kdotchandra/ball-balancing-robot/README.md

# Ball-Balancing Robot (3-DOF Parallel Platform)

Capstone Design Project, Mechatronics Engineering, Suranaree University of Technology (2026).
Team of 3. I was responsible for the wiring, assembly, and all software.

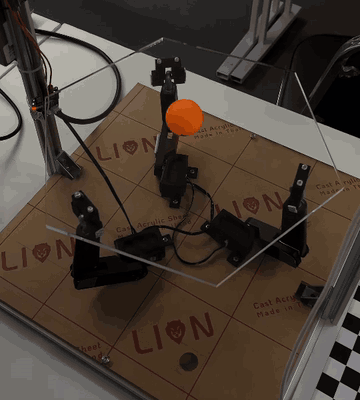
[picture p1: docs/media/demo_balance.gif]
The platform keeps a ping-pong ball on the plate while the ball is pushed away with a stick


*Balance: the ball is pushed away with a stick and the plate brings it back.*

## What it does
A 3RRS platform tilts a plate to keep a ping-pong ball balanced at the center
and to move it along a circle or hexagon path.

| Demo | Result (tuned profiles, 2026-09-28) |
|---|---|
| Balance | Ball placed 5–9 cm from center is brought within 2 cm in about 0.5–5 s |
| Circle, 3 cm radius | Tracking error about 1.3–1.5 cm |
| Hexagon, 3.46 cm to corner | Tracking error about 1.4–2.1 cm |

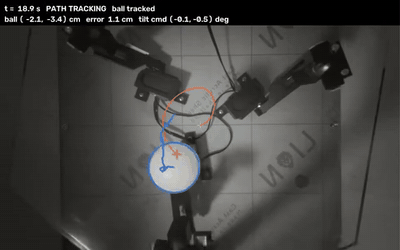
[picture p2: docs/media/demo_circle.gif]
Overhead camera view: the ball follows a circular reference path
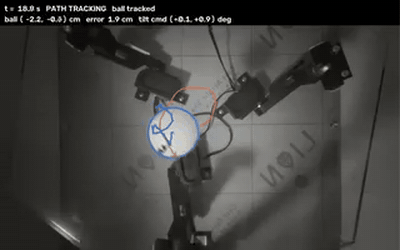
[picture p3: docs/media/demo_hexagon.gif]
Overhead camera view: the ball follows a hexagonal reference path
 

*Circle (left) and hexagon (right) paths, seen by the control camera: orange is the reference path, blue is the detected ball and its recent path.*

## How it works
```
Camera (OV9281, 30 fps) -> ball detection (OpenCV) -> alpha-beta velocity filter
-> LQR controller -> plate tilt angles -> linearized inverse kinematics
-> servo commands over UART -> 3 x HX-35H servos
```
Plate tilt is converted to servo angles with the inverse kinematics of the 3RRS mechanism, linearized
around the neutral pose (a fixed 3x2 matrix in `servo_calibration/config/servo_mapping.json`; the servo
directions were checked on the real platform). The exact inverse kinematics (`kinematics.py`) is kept for
checking and simulation: with the CAD geometry it differs from the linear map by about 2.5% at small
tilts, and by less than 2 servo counts within ±3° of tilt.

## Hardware
- Raspberry Pi 5 (Raspberry Pi OS, Python)
- OV9281 global-shutter camera, mounted about 25 cm above the plate
- 3 x Hiwonder HX-35H bus servos, driven from the Pi's UART through a Hiwonder BusLinker v3.0
- 12 V 16.7 A power supply for the servos; the Pi has a separate supply
- 3RRS mechanism with an acrylic plate and a 40 mm ping-pong ball

## Repository layout
```
docs/                     Handoff notes, demo instructions (Thai)
test_integrated_system/   Main control loop (main.py), controller, tracker, calibration, tests
ping_pong_tracker/        Camera and detector setup, calibration files
servo_*/                  Arduino sketches used for early servo tests
```

## Run the demo
See [docs/DEMO_RUN.md](docs/DEMO_RUN.md). Full project notes: [docs/HANDOFF.md](docs/HANDOFF.md).

Tests run without hardware:
```bash
python -m pytest test_integrated_system/tests
```

## Known limitations
- Stick-slip friction between the ball and the plate limits accuracy.
- The camera only sees about +/-8 cm from the center.
- Total loop delay is about 170 ms (camera, detection, command timing and servo response).

## License
MIT. See [LICENSE](LICENSE).
