kdotchandra/ball-balancing-robot/docs/DEMO_RUN.md

# วิธีรัน Demo (Ball-and-Plate)

## เตรียมก่อนรัน

1. เช็กพินและข้อต่อทุกตัวว่าแน่น (พินหลวมทำให้ balance แย่ลงมาก)
2. เตรียมมือไว้ใกล้สวิตช์ไฟ servo
3. ปิด `web_stream.py` ก่อน เพราะกล้องใช้ได้ทีละโปรแกรม
4. เข้าโฟลเดอร์

```bash
cd /home/rpi5/capstone_design/test_integrated_system
```

## ตอนแสดงจริง (ทำงานต่อเนื่องจนกว่าจะกด Ctrl+C)

| Demo | คำสั่ง | วางบอลที่ |
|---|---|---|
| Balance | `./demo_balance.sh` | ตรงไหนก็ได้ในระยะกล้อง (ห่างกลางไม่เกิน ~7 cm) |
| เดินตามเส้นวงกลม | `./demo_circle.sh` | ใกล้กลาง |
| เดินตามเส้นหกเหลี่ยม | `./demo_hexagon.sh` | ใกล้กลาง |

ขั้นตอน:

1. พิมพ์คำสั่ง
2. วางบอลบนแผ่น
3. กด **Enter** เมื่อขึ้นข้อความให้ยืนยัน
4. กด **Ctrl+C** เมื่อต้องการหยุด แผ่นจะกลับไปที่ neutral และสคริปต์แสดงบรรทัด `RESULT:` สรุปผล

ลำดับการทำงานของวงกลมและหกเหลี่ยม: ทรงตัวที่กลาง 6 s → ค่อยๆ ขยายเส้นออก 5 s → วิ่งตามเส้นวนไปเรื่อยๆ (รอบละ 20 s)

## ให้หยุดเองตามเวลา (ตอนอัดวิดีโอไปทำกราฟ หรือเก็บข้อมูล)

```bash
./demo_balance.sh --duration-s=25
./demo_circle.sh --duration-s=50
./demo_hexagon.sh --duration-s=50
```

ทุก demo อัดวิดีโอเก็บไว้ใน `logs/video_<เวลา>.mp4` และ log ใน `logs/run_<เวลา>.csv` (tag แสดงตอนจบรอบ)

## ข้อควรจำ

- หยุดด้วย **Ctrl+C ครั้งเดียว** ห้ามใช้ Ctrl+Z (process จะค้างถือกล้องและ servo ไว้)
- รันทีละตัว รอให้ตัวก่อนจบก่อน
- ถ้าบอลหลุด แผ่นกลับ neutral แล้วรอ วางบอลกลับแล้วระบบควบคุมต่อเอง
  - วงกลม/หกเหลี่ยม เส้นยังเดินต่อจากเวลาเดิม ถ้าอยากเริ่มใหม่ตั้งแต่ช่วงทรงตัวที่กลาง ให้ Ctrl+C แล้วรันใหม่
- ระวังมือหรือเงาบังกล้องระหว่างรัน
- วิดีโอจะใหญ่ขึ้นตามเวลาที่รัน ถ้าแสดงนานหลายนาที เช็กพื้นที่ดิสก์ด้วย

## ถ้ามีปัญหา

| อาการ | ทำอย่างไร |
|---|---|
| ขึ้นว่ามีโปรแกรมกล้องอื่นทำงานอยู่ | ปิดโปรแกรมนั้นด้วย Ctrl+C หรือ `pkill -f web_stream.py` แล้วรันใหม่ |
| บอลแกว่งเป็นจังหวะเร็ว ~1 ครั้งต่อวินาที และแรงขึ้นเรื่อยๆ | กด Ctrl+C แล้วรันใหม่ ถ้าเกิดซ้ำให้เช็กพินและข้อต่อ |
| Pi ดับหรือรีบูตเองระหว่างรัน | เช็กแหล่งจ่ายไฟ (servo อาจดึงกระแสจนไฟตก) |
| จับบอลไม่ได้ / วงเขียวไปจับที่อื่น | เช็กแสงในห้อง ดูภาพผ่าน `web_stream.py` (ต้องปิดก่อนรัน demo) |

## ค่าที่ใช้ในแต่ละ demo (จูนเมื่อ 2026-09-28)

ค่าอยู่ที่เดียวใน `test_integrated_system/experiment_profile.py` → `PROFILES` (พร้อม comment หลักฐานของแต่ละค่า)
ดูได้ด้วย `python experiment_profile.py --list`

| Demo | Profile | ผลจากการทดสอบ |
|---|---|---|
| Balance | `tuned_balance` | ดึงบอลที่วางห่างกลาง 5–9 cm เข้ามาใกล้กลาง 2 cm ภายใน ~0.5–5 s; ผลักบอลออก 5 ครั้งดึงกลับได้ทุกครั้ง |
| วงกลม (รัศมี 3 cm) | `tuned_circle` | tracking error ~1.3–1.5 cm, 14 รอบไม่แกว่งค้าง |
| หกเหลี่ยม (รัศมีถึงมุม 3.46 cm) | `tuned_hexagon` | tracking error ~1.4–2.1 cm, ไม่แกว่งค้าง |

- ค่า standard (ที่รายงานบทที่ 4 ใช้) ยังเป็นค่าเริ่มต้นของ `run_real_balance.sh` ไม่ได้เปลี่ยน
- หกเหลี่ยมไม่ใช้ dz-lead เพราะทั้ง 0.25° และ 0.40° ทำให้แกว่งค้างจนบอลหลุดเป็นครั้งคราว
- dz-lead ของวงกลมเกิน ~0.4° จะเริ่มแกว่งค้าง (0.70° แกว่งที่ 0.74 Hz)
- รายละเอียดทั้งหมด: [HANDOFF.md](HANDOFF.md)
