kdotchandra/ball-balancing-robot/ping_pong_tracker/camera_capture.png

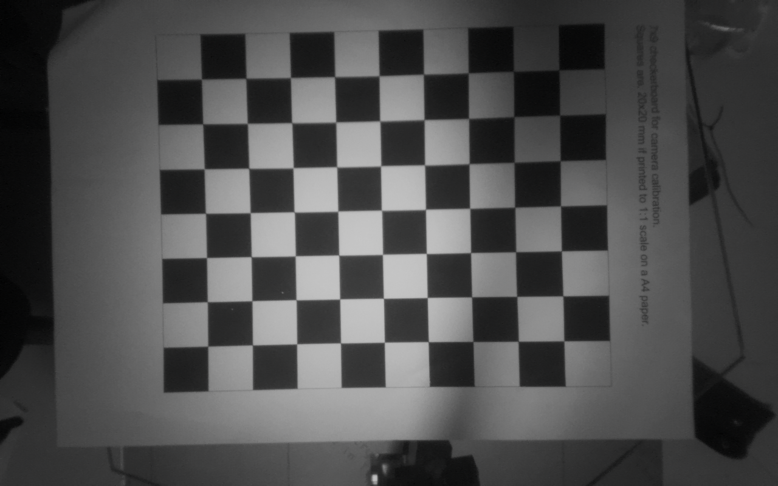
ping_pong_tracker/camera_capture.png
