kdotchandra/ball-balancing-robot/ping_pong_tracker/flat_field.png

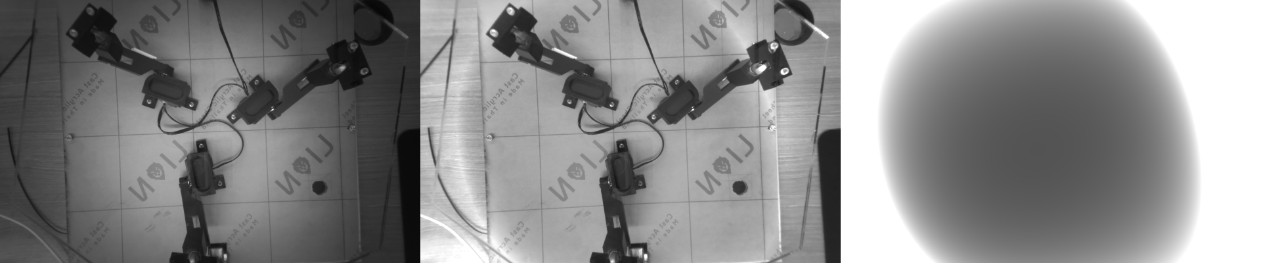
ping_pong_tracker/flat_field.png
