kdotchandra/ball-balancing-robot/test_integrated_system/logs/detect_20260927T065947Z.csv

t_s | dt_s | detected | confidence | x_m | y_m | x_px | y_px | radius_px | frame_age_s
0.0930 | 0.0160 | 0 |  |  |  |  |  |  | 0.0104
0.1124 | 0.0787 | 1 | 0.963 | 0.02161 | 0.03266 | 726.0 | 270.0 | 74.0 | 0.0225
0.1303 | 0.0212 | 1 | 0.963 | 0.02161 | 0.03266 | 726.0 | 270.0 | 74.0 | 0.0103
0.1637 | 0.0335 | 1 | 0.963 | 0.02211 | 0.03216 | 728.0 | 272.0 | 74.0 | 0.0106
0.1977 | 0.0334 | 1 | 0.988 | 0.02110 | 0.03316 | 724.0 | 268.0 | 78.0 | 0.0106
0.2305 | 0.0333 | 1 | 0.975 | 0.02161 | 0.03266 | 726.0 | 270.0 | 76.0 | 0.0106
0.2637 | 0.0334 | 1 | 0.975 | 0.02161 | 0.03266 | 726.0 | 270.0 | 76.0 | 0.0106
0.2985 | 0.0332 | 1 | 0.975 | 0.02211 | 0.03266 | 728.0 | 270.0 | 76.0 | 0.0105
0.3276 | 0.0334 | 1 | 0.963 | 0.02161 | 0.03266 | 726.0 | 270.0 | 74.0 | 0.0106
0.3637 | 0.0333 | 1 | 0.975 | 0.02161 | 0.03266 | 726.0 | 270.0 | 76.0 | 0.0106
0.3970 | 0.0334 | 1 | 0.975 | 0.02211 | 0.03266 | 728.0 | 270.0 | 76.0 | 0.0106
0.4306 | 0.0332 | 1 | 0.988 | 0.02110 | 0.03316 | 724.0 | 268.0 | 78.0 | 0.0105
0.4609 | 0.0335 | 1 | 0.988 | 0.02110 | 0.03316 | 724.0 | 268.0 | 78.0 | 0.0107
0.4943 | 0.0332 | 1 | 0.963 | 0.02161 | 0.03266 | 726.0 | 270.0 | 74.0 | 0.0105
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
