kdotchandra/ball-balancing-robot/test_integrated_system/logs/run_20260923T205222Z.csv

t_s | dt_s | mode | detected | control_valid | confidence | x_m | y_m | x_ref_m | y_ref_m | x_dot_mps | y_dot_mps | theta_x_cmd_deg | theta_y_cmd_deg | theta_x_actual_deg | theta_y_actual_deg | servo1 | servo2 | servo3 | missed_frames | lost_neutralized
0.1096 | 0.1521 | 1 | 0 | 0 |  | 0.00000 | 0.00000 | 0.00000 | 0.00000 | 0.00000 | 0.00000 | 0.000 | 0.000 | 0.000 | 0.000 | 441 | 402 | 423 | 0 | 0
0.1992 | 0.1099 | 1 | 1 | 1 | 0.869 | -0.00201 | -0.03241 | 0.00000 | 0.00000 | -0.01829 | -0.29487 | 1.912 | -10.163 | 1.158 | -6.156 | 459 | 437 | 458 | 0 | 0
0.3231 | 0.1132 | 1 | 1 | 1 | 0.848 | -0.00201 | -0.03191 | 0.00000 | 0.00000 | 0.00000 | 0.00444 | -0.956 | 0.316 | -0.161 | -2.116 | 459 | 437 | 458 | 0 | 0
0.4290 | 0.0999 | 1 | 1 | 1 | 0.879 | -0.00201 | -0.03191 | 0.00000 | 0.00000 | 0.00000 | 0.00000 | 0.850 | -6.335 | 0.396 | -4.440 | 449 | 450 | 471 | 0 | 0
0.5579 | 0.1279 | 1 | 1 | 1 | 0.812 | -0.00301 | -0.03090 | 0.00000 | 0.00000 | -0.00786 | 0.00786 | 1.134 | -1.645 | 0.916 | -2.470 | 452 | 415 | 436 | 0 | 0
0.6684 | 0.1280 | 1 | 1 | 1 | 0.767 | -0.00779 | -0.03090 | 0.00000 | 0.00000 | -0.03729 | 0.00000 | 1.912 | -5.492 | 1.618 | -4.602 | 452 | 415 | 436 | 0 | 0
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
