kdotchandra/ball-balancing-robot/test_integrated_system/logs/run_20260923T205301Z.csv

t_s | dt_s | mode | detected | control_valid | confidence | x_m | y_m | x_ref_m | y_ref_m | x_dot_mps | y_dot_mps | theta_x_cmd_deg | theta_y_cmd_deg | theta_x_actual_deg | theta_y_actual_deg | servo1 | servo2 | servo3 | missed_frames | lost_neutralized
0.0922 | 0.1521 | 1 | 0 | 0 |  | 0.00000 | 0.00000 | 0.00000 | 0.00000 | 0.00000 | 0.00000 | 0.000 | 0.000 | 0.000 | 0.000 | 441 | 402 | 423 | 0 | 0
0.1969 | 0.0925 | 1 | 1 | 1 | 0.730 | -0.02487 | -0.00578 | 0.00000 | 0.00000 | -0.26890 | -0.06247 | 1.912 | -8.368 | 0.974 | -4.266 | 459 | 437 | 458 | 0 | 0
0.3057 | 0.1251 | 1 | 1 | 1 | 0.738 | -0.02462 | -0.00553 | 0.00000 | 0.00000 | 0.00201 | 0.00201 | 1.912 | 1.102 | 1.621 | -0.563 | 459 | 437 | 458 | 0 | 0
0.4053 | 0.0880 | 1 | 1 | 1 | 0.738 | -0.02462 | -0.00553 | 0.00000 | 0.00000 | 0.00000 | 0.00000 | 1.912 | -0.797 | 1.762 | -0.676 | 459 | 402 | 423 | 0 | 0
0.5314 | 0.1202 | 1 | 1 | 1 | 0.706 | -0.02537 | -0.00678 | 0.00000 | 0.00000 | -0.00627 | -0.01045 | 1.912 | -2.110 | 1.861 | -1.626 | 459 | 410 | 431 | 0 | 0
0.6564 | 0.1279 | 1 | 1 | 1 | 0.637 | -0.02789 | -0.00703 | 0.00000 | 0.00000 | -0.01964 | -0.00196 | 1.912 | 0.168 | 1.897 | -0.361 | 459 | 392 | 413 | 0 | 0
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
