kdotchandra/ball-balancing-robot/test_integrated_system/logs/run_20260923T210003Z.csv

t_s | dt_s | mode | detected | control_valid | confidence | x_m | y_m | x_ref_m | y_ref_m | x_dot_mps | y_dot_mps | theta_x_cmd_deg | theta_y_cmd_deg | theta_x_actual_deg | theta_y_actual_deg | servo1 | servo2 | servo3 | missed_frames | lost_neutralized
0.0819 | 0.1521 | 1 | 0 | 0 |  | 0.00000 | 0.00000 | 0.00000 | 0.00000 | 0.00000 | 0.00000 | 0.000 | 0.000 | 0.000 | 0.000 | 441 | 402 | 423 | 0 | 0
0.1592 | 0.0823 | 1 | 1 | 1 | 0.821 | -0.01683 | 0.00980 | 0.00000 | 0.00000 | -0.20448 | 0.11903 | 1.912 | 1.102 | 0.867 | 0.500 | 459 | 392 | 413 | 0 | 0
0.2487 | 0.0996 | 1 | 1 | 1 | 0.817 | -0.01633 | 0.00980 | 0.00000 | 0.00000 | 0.00504 | 0.00000 | 1.912 | 1.102 | 1.441 | 0.831 | 459 | 392 | 413 | 0 | 0
0.3154 | 0.0665 | 1 | 1 | 1 | 0.814 | -0.01633 | 0.00955 | 0.00000 | 0.00000 | 0.00000 | -0.00378 | 1.912 | 1.102 | 1.613 | 0.930 | 459 | 392 | 413 | 0 | 0
0.4029 | 0.0894 | 1 | 1 | 1 | 0.815 | -0.01532 | 0.01055 | 0.00000 | 0.00000 | 0.01125 | 0.01125 | 0.936 | 1.102 | 1.280 | 1.015 | 459 | 392 | 413 | 0 | 0
0.4798 | 0.0647 | 1 | 1 | 1 | 0.807 | -0.01432 | 0.01080 | 0.00000 | 0.00000 | 0.01552 | 0.00388 | 0.691 | 1.102 | 1.069 | 1.046 | 448 | 392 | 413 | 0 | 0
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
