kdotchandra/ball-balancing-robot/test_integrated_system/logs/run_20260923T210017Z.csv

t_s | dt_s | mode | detected | control_valid | confidence | x_m | y_m | x_ref_m | y_ref_m | x_dot_mps | y_dot_mps | theta_x_cmd_deg | theta_y_cmd_deg | theta_x_actual_deg | theta_y_actual_deg | servo1 | servo2 | servo3 | missed_frames | lost_neutralized
0.1075 | 0.1522 | 1 | 0 | 0 |  | 0.00000 | 0.00000 | 0.00000 | 0.00000 | 0.00000 | 0.00000 | 0.000 | 0.000 | 0.000 | 0.000 | 441 | 402 | 423 | 0 | 0
0.1956 | 0.1076 | 1 | 1 | 1 | 0.814 | -0.02035 | -0.02638 | 0.00000 | 0.00000 | -0.18904 | -0.24505 | 1.912 | -10.163 | 1.134 | -6.030 | 459 | 437 | 458 | 0 | 0
0.3064 | 0.1108 | 1 | 1 | 1 | 0.774 | -0.02135 | -0.02588 | 0.00000 | 0.00000 | -0.00907 | 0.00454 | 1.912 | 1.102 | 1.609 | -1.675 | 459 | 437 | 458 | 0 | 0
0.3946 | 0.0878 | 1 | 1 | 1 | 0.811 | -0.02010 | -0.02562 | 0.00000 | 0.00000 | 0.01431 | 0.00286 | 1.912 | -4.822 | 1.755 | -3.197 | 459 | 432 | 453 | 0 | 0
0.5071 | 0.1081 | 1 | 1 | 1 | 0.820 | -0.02135 | -0.02512 | 0.00000 | 0.00000 | -0.01162 | 0.00465 | 1.912 | -2.153 | 1.848 | -2.575 | 459 | 432 | 453 | 0 | 0
0.6057 | 0.0925 | 1 | 1 | 1 | 0.769 | -0.02286 | -0.02437 | 0.00000 | 0.00000 | -0.01630 | 0.00815 | 1.912 | -2.507 | 1.881 | -2.540 | 459 | 413 | 434 | 0 | 0
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
