kdotchandra/ball-balancing-robot/test_integrated_system/logs/run_20260923T213735Z.csv

t_s | dt_s | mode | detected | control_valid | confidence | x_m | y_m | x_ref_m | y_ref_m | x_dot_mps | y_dot_mps | theta_x_cmd_deg | theta_y_cmd_deg | theta_x_actual_deg | theta_y_actual_deg | servo1 | servo2 | servo3 | missed_frames | lost_neutralized
0.0812 | 0.1522 | 1 | 0 | 0 |  | 0.00000 | 0.00000 | 0.00000 | 0.00000 | 0.00000 | 0.00000 | 0.000 | 0.000 | 0.000 | 0.000 | 441 | 402 | 423 | 0 | 0
0.1600 | 0.0815 | 1 | 1 | 1 | 0.906 | 0.00276 | 0.00980 | 0.00000 | 0.00000 | 0.03393 | 0.12028 | -3.000 | 3.000 | -1.347 | 1.347 | 413 | 392 | 413 | 0 | 0
0.2474 | 0.1011 | 1 | 1 | 1 | 0.906 | 0.00276 | 0.00980 | 0.00000 | 0.00000 | 0.00000 | 0.00000 | 1.231 | 0.879 | 0.090 | 1.086 | 413 | 392 | 413 | 0 | 0
0.3116 | 0.0647 | 1 | 1 | 1 | 0.906 | 0.00251 | 0.00980 | 0.00000 | 0.00000 | -0.00388 | 0.00000 | -0.478 | 1.278 | -0.113 | 1.155 | 436 | 394 | 415 | 0 | 0
0.3961 | 0.0860 | 1 | 1 | 1 | 0.944 | 0.00276 | 0.00904 | 0.00000 | 0.00000 | 0.00292 | -0.00877 | -0.967 | 0.016 | -0.517 | 0.615 | 436 | 394 | 415 | 0 | 0
0.4746 | 0.0635 | 1 | 1 | 1 | 0.969 | 0.00276 | 0.00904 | 0.00000 | 0.00000 | 0.00000 | 0.00000 | -0.038 | 1.772 | -0.349 | 1.020 | 441 | 388 | 409 | 0 | 0
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
