kdotchandra/ball-balancing-robot/(commit log)

2026-09-28 Snapshot before handoff cleanup
    State of the ball-and-plate project as tuned for the advisor demo (2026-09-28):
    code, calibration configs, notebooks, demo scripts and every run log (CSV + JSON
    sidecar). Debug frames, videos and presentation output stay out of git.
    [detect_20260927T065947Z.csv, run_20260923T205222Z.csv, run_20260923T205301Z.csv, run_20260923T210003Z.csv, run_20260923T210017Z.csv, run_20260923T213735Z.csv, run_20260923T213758Z.csv, run_20260923T213846Z.csv]
2026-09-28 Record the measured hardware facts and add the tuning analysis tool
    theory_limits.MEASURED gains the values measured on 2026-09-27/28 with servo read-back
    (servo time constant 0.11 s, the loop-delay budget, servo dead band, rolling plant gain,
    stiction break-away range, velocity noise, dead-zone-lead limit-cycle thresholds), each
    with its source. The existing keys and the chapter-4 targets are unchanged (the
    theory_limits.py printout is identical). params.py no longer claims the LQR notebook is
    missing. analyze_runs.py turns the one-off tuning analyses into a tool: per-run and per-tag
    tracking/balance metrics, limit-cycle detection, servo jitter, drop-out locations and a
    permutation test aga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
    [analyze_runs.py, params.py, theory_limits.py]
2026-09-28 Make a new Pi installable: requirements and setup_pi.sh
    requirements.txt pins the Python packages the project was tuned with (Windows-only camera
    helpers behind a platform marker); picamera2/libcamera stay apt packages, as ball_tracker.py
    already imports them from the system site-packages. requirements-dev.txt adds pytest.
    setup_pi.sh --check reports Python, apt packages, the serial port and dialout group, the
    camera, the venv against requirements.txt, the calibration files and free disk space;
    --install adds what is missing. It passes on this Pi.
2026-09-28 Add a hardware-free test suite
    test_integrated_system/tests (pytest, 23 tests, < 1 s): unit tests for the velocity filter,
    friction compensation, dither, gain scheduling and path-tuning helpers, the LQR sign
    conventions and clipping, and exact-IK symmetry; profile tests that pin the standard values
    and the tuned profiles the demos use; and replay tests on two real 2026-09-28 runs that
    recompute every logged tilt command from the logged state (max error < 0.01 deg) and check
    run_metrics / analyze_runs scores. The replay test catches a 5 % change in the controller
    output or a lost gain schedule.
    [run_20260928T140759Z.csv, run_20260928T141337Z.csv]
2026-09-28 Document the project for handoff
    HANDOFF.md (project root): how the system works, hardware, file map, installation,
    calibration order (with the /dev/serial0 vs ttyUSB0 note), running, the tuning method
    that worked (interleaved runs, per-shape validation, limit-cycle check), every flag with
    its status and evidence, the measured facts, known problems (loose pins, power dips,
    lighting, camera edge, the linearized-vs-exact IK gap) and open work. The
    test_integrated_system README now states the real status and points to HANDOFF.md and
    setup_pi.sh; DEMO_RUN.md refers to the named profiles instead of repeating values.
2026-09-28 Add verification run: demo_circle with --profile=tuned_circle
    [run_20260928T161322Z.csv]
2026-09-28 Show ball position, reference and error in mm on screen
    The status lines ([BAL]/[TRK]), the detailed print and the preview-window text now use
    millimetres (one decimal) instead of metres. The CSV logs keep metres, which run_metrics,
    analyze_runs, the tests and all existing logs rely on.
    [main.py]
2026-09-28 Clearer status line: only the values the controller uses
    The status line now shows the ball position (mm), the distance to the centre or the path
    reference and error (mm), the commanded tilt (deg) and the positions actually sent to the
    servos, labelled [BAL] / [HOLD] / [RAMP] / [PATH]. The old servo_cmd / servo_theory /
    servo_err / obs fields were linearized and exact IK angles computed only for printing;
    they never drove the servos (servo_mapping does) and disagreed by ~10x because of K_ACT,
    which made them misleading. That per-loop IK computation and four unused print helpers are
    removed; kinematics.py and its tests are unchanged.
    [main.py]
2026-10-07 Document wiring and power, add MIT license
    - HANDOFF.md: Pi-to-BusLinker wiring, power supplies, camera height,
    notebook packages, where the system identification data is
    - README.md: hardware details and license section
    - Add LICENSE (MIT)
2026-10-07 HANDOFF.md: add a wiring and setup checklist for first-time builders
2026-10-10 Fix 3RRS IK geometry; stop tracking presentation and report files
    Geometry (params.py, kinematics.py, platform_3d_simulation.py):
    - RP = 130 mm, measured in the CAD top view (130.00 / 129.96 / 130.04)
    - Servos sit inside the anchor circle with legs pointing outward;
    RB = RP - L1*cos(25 deg), so Link 2 is vertical at neutral
    - The ball joint hangs ANCHOR_DROP = 28 + 6 mm below the plate top and
    tilts with the plate. The exact IK now reaches at neutral (q1 = 25.03 deg)
    instead of clamping cos_q2
    - The simulation imports geometry from params.py instead of a stale copy
    With this geometry the IK Jacobian is 2.21 / 1.91, within ~2.5% of the
    servo_mapping coefficients 2.26 / 1.96 used by the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
    [kinematics.py, params.py, platform_3d_simulation.py, test_freq_response.py, video_recorder.py]
2026-10-10 Docs: describe the tilt-to-servo map as linearized inverse kinematics
    The README, HANDOFF and servo_calibration README said the servo mapping was
    measured during calibration and that IK does not drive the servos. The map
    in servo_mapping.json is the 3RRS inverse kinematics linearized around the
    neutral pose; only the servo directions were checked on the real platform.
    With the CAD geometry it is within ~2.5% of the exact IK Jacobian.
    Also update the HANDOFF note on linearized_ik(): after the geometry fix it
    differs from the exact IK by ~6.7% (stale K_ACT), not ~10x.
    [kinematics.py]
